art-logics-hw/cell-simulator/README.md

# Cell Simulator

Battery cell simulator hardware design

## Issues

* [ ] `CAN1_TX` and `CAN1_RX` is swapped.
* [ ] R32 (120ohm) between `CAN1_TX` and `CAN1_RX` should be removed.
* [ ] Add 100ohm, 0.5W resistor between GND and V- of U19 DC-DC module for positive/negative balancing.
