art-logics-hw/cell-simulator/hardware/cell-simulator.kicad_pcb

## KiCad design hardware/cell-simulator.kicad_pcb (2022-07-04)

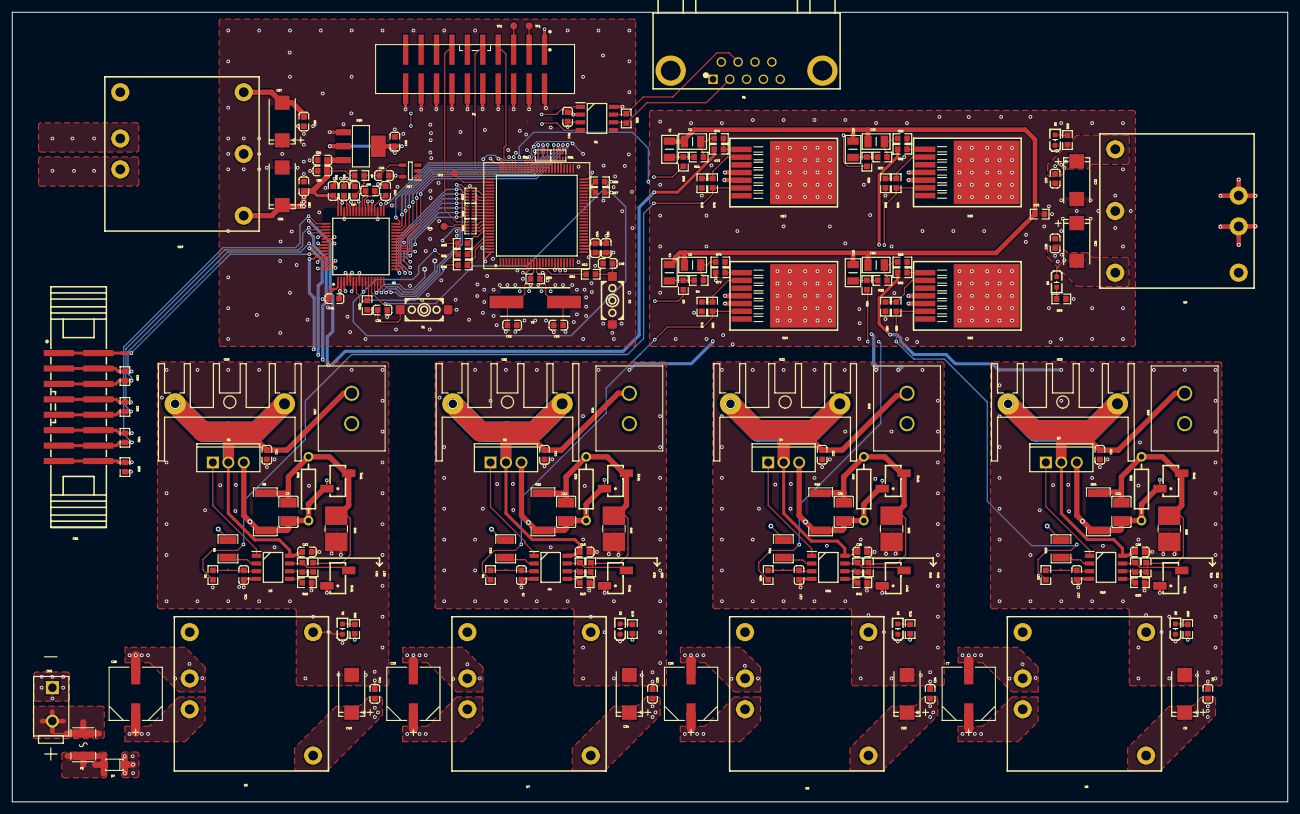
[picture p1: board cell-simulator.kicad_pcb from above]

Board: 4 copper layers, 210.0 x 130.0 mm, 201 parts (0 on the bottom side), 156 nets.

Parts:
C1, C2, C4, C5, C15, C16, C25, C26: CAPC3216X190N
C3, C12, C22, C31: C1210
C6, C9, C10, C11, C13, C14, C17, C18, C19, C21, C24, C27, C28, C30, C35, C37, C38, C39, C40, C41, C42, C44, C45, C46, C47, C48, C49, C50, C51, C52, C53, C54, C55, C58, C59, C60, C61: LC-0603_C
C7, C20, C29, C33: CAP_J-V_8X10P5_RUB
C8, C23, C32, C34, C36, C43, C56, C57: CAPPM7343X310N
CN1: IDC-SMD_16P-P2.54_Z-S230321016M2BLT1
CN2: 39-28-8020
D1, D2, D3, D4, D5, D6: LED0603-R-RD
D7: SOD-123FL_L2.7-W1.8-LS3.8-RD
F1: F1812
P1: CONN-SMD_20P-P2.54_B-3000N20P-0110
Q1, Q2, Q3, Q4: TO255P460X1020X2008-3P
R2, R3, R4, R8, R10, R11, R13, R14, R17, R18, R19, R20, R24, R25, R27, R30, R31, R32, R36, R37, R39, R42, R43, R44, R51, R52, R53, R55, R56, R57, R58, R59, R60, R61, R62, R63, R64, R65, R66, R69, R70, R71, R72, R73, R74, R75, R76, R77, R78, R79, R80, R81, R82, R83, R84, R85, R86, R87, R88, R89, R90: LC-0603_R
R5, R22, R34, R46: R2512
R6, R12, R29, R41: R1210
R16, R23, R35, R47: MF0W4FF6801A50
R21, R33, R45, R67: RX27-5
R48, R49, R50, R68: PA2512FKE7W0R001E
RN1, RN2, RN3, RN4, RN5: RES-ARRAY-SMD_0402-8P-L2.0-W1.0-BL
S1, S2: KEY-SMD_L6.2-W3.6-LS8.0
TP1, TP2, TP3, TP4: PAD-1.2
TPV1, TPV2, TPV3, TPV4, TPV5, TPV6, TPV7, TPV8: HDR-SMD_2P-P2.54-V-M-S4.8
U1: SOIC127P600X175-8N
U2: QFP50P1200X1200X160-64N
U3, U4, U10, U11: LM2904BQDRQ1
U5, U6, U7, U8: URBXXXXYMD-10WR3
U9, U19: URAXXXXYMD-10WR3
U12: QFP50P1600X1600X160-100N
U13, U14, U15, U16: KTW7
U17: SOT95P280X145-5N
U18: SOT-223_L6.5-W3.5-P2.30-LS7.0-BR
U20, U21, U22, U23: HEATSINK-TH_L23.5-W16.0-P18.0_XSD2156-06
X1: DSUB-TH_DMR-9S
Y1: ABLS-12.000MHZ-B2

Connections:
2V5REF: C47.2, C48.1, R55.2, U2.42, U17.4
$$$1152: C3.1, R5.1, R16.1, R17.1, R48.2, TPV1.2
$$$1196: C12.1, R20.1, R22.1, R23.1, R49.2, TPV3.2
$$$1298: C22.1, R32.1, R34.1, R35.1, R50.2, TPV6.2
$$$1418: C31.1, R44.1, R46.1, R47.1, R68.2, TPV8.2
$$$1466: C6.1, R8.2, U4.3
$$$1467: R12.1, U4.2
$$$1468: C4.2, R3.2, R4.1
$$$1469: Q2.1, U4.1
$$$1470: C10.1, C11.1, Q2.2, R21.1, U4.8, U21.1, U21.2
$$$1471: R19.1, TPV2.2, U4.7
$$$1472: R13.2, U4.5
$$$1473: R19.2, R20.2, U4.6
$$$1474: C17.1, R27.2, U10.3
$$$1475: R29.1, U10.2
$$$1476: C15.2, R24.2, R25.1
$$$1477: Q3.1, U10.1
$$$1478: C18.1, C19.1, Q3.2, R33.1, U10.8, U23.1, U23.2
$$$1479: R31.1, TPV4.2, U10.7
$$$1480: R30.2, U10.5
$$$1481: R31.2, R32.2, U10.6
$$$1482: C27.1, R39.2, U11.3
$$$1483: R41.1, U11.2
$$$1484: C25.2, R36.2, R37.1
$$$1485: Q4.1, U11.1
$$$1486: C28.1, C30.1, Q4.2, R45.1, U11.8, U22.1, U22.2
$$$1487: R43.1, TPV7.2, U11.7
$$$1488: R42.2, U11.5
$$$1489: R43.2, R44.2, U11.6
$$$3411: R6.1, U3.2
$$$3420: C21.1, R2.2, U3.3
$$$4490: C1.2, R10.2, R11.1
$$$7976: P1.3, TP1.1
$$$7978: P1.5, TP2.1
$$$8071: TP3.1, U12.77
$$$8097: RN4.7, TP4.1
$$$10062: Q1.1, U3.1
$$$10192: C13.1, C14.1, Q1.2, R67.1, U3.8, U20.1, U20.2
$$$10374: R14.1, TPV5.2, U3.7
$$$10421: R18.2, U3.5
$$$10474: R14.2, R17.2, U3.6
$$$12937: D7.2, F1.2
$$$15374: R73.2, R74.2, U13.1
$$$15480: R75.2, R76.1, U13.2
$$$15551: R77.2, R78.2, U14.1
$$$15552: R79.2, R80.1, U14.2
$$$15559: R81.2, R82.2, U15.1
$$$15560: R83.2, R84.1, U15.2
$$$15562: R85.2, R86.2, U16.1
$$$15563: R87.2, R88.1, U16.2
$$$16325: CN2.2, F1.1
$$$16602: D5.1, R89.1
$$$16631: D6.1, R90.1
$$$18206: C39.1, R51.2, S1.1
$$$18291: C40.1, R52.2, S2.1
$$$18913: R53.1, U1.6, X1.2
$$$18918: R53.2, U1.7, X1.7
$$$20459: C46.1, U2.36
$$$24853: D1.1, R66.2
$$$24877: D3.1, R69.2
$$$24913: D4.1, R71.2
$$$24942: D2.1, R70.2
$$$28916: C52.2, R56.2, U12.12, Y1.2
$$$28919: C53.2, R56.1, U12.13, Y1.1
$$$29529: R57.2, U12.47
$$$29530: R58.2, U12.48
$$$29769: RN1.4, U12.58
$$$29771: RN1.3, U12.57
$$$29772: RN1.2, U12.56
$$$29773: RN1.1, U12.55
$$$29939: RN2.4, U12.62
$$$30112: RN2.1, U12.59
$$$30117: RN2.2, U12.60
$$$30238: RN2.3, U12.61
$$$30640: RN5.1, U12.85
$$$30641: RN5.2, U12.86
$$$30643: RN5.3, U12.87
$$$30645: RN5.4, U12.88
$$$30652: RN3.4, U12.84
$$$30655: RN3.3, U12.83
$$$30661: RN3.2, U12.82
$$$30664: RN3.1, U12.81
$$$30684: RN4.1, U12.89
$$$30687: RN4.2, U12.90
$$$30690: RN4.3, U12.91
$$$30693: RN4.4, U12.92
$$$31167: R60.1, U12.93
$$$31288: R61.1, U12.95
$$$31389: R59.1, U12.96
$$$31870: C57.1, C59.2, U19.5
$$$32347: C45.1, U2.40
$$$32491: C45.2, U2.39
$$$32715: C60.1, U2.44, U2.45
+3V3: C49.1, C54.2, C55.2, P1.1, U2.23, U12.11, U12.19, U12.22, U12.28, U12.50, U12.75, U12.100, U18.2, U18.4
+5V: C41.2, C42.1, C50.1, C51.1, C56.2, C58.1, C61.1, R55.1, U1.3, U2.1, U2.37, U2.38, U2.48, U18.3, U19.3
+9V_1: C43.2, C44.2, R66.1, R67.2, U5.3
+9V_2: C34.2, C35.2, R21.2, R70.1, U7.3
+9V_3: C23.2, C24.2, R45.2, R71.1, U8.3
+9V_4: C8.2, C9.2, R33.2, R69.1, U6.3
+24V: C7.1, C20.1, C29.1, C33.1, D7.1, U5.2, U6.2, U7.2, U8.2, U9.2, U19.2
-24V: C7.2, C20.2, C29.2, C33.2, CN2.1, U5.1, U6.1, U7.1, U8.1, U9.1, U19.1
AD1RST: R51.1, U2.11
BUSY: U2.14, U12.71
C1: C3.2, CN1.13, CN1.14, Q1.3, R5.2, R6.2, R16.2, R64.2, TPV1.1, U2.49
C1A: C2.2, R11.2, R74.1
C1D: R10.1, U12.63
C1I: R2.1, R76.2, U13.6
C2: C12.2, CN1.9, CN1.10, Q2.3, R22.2, R23.2, R63.2, TPV3.1, U2.51
C2A: C5.2, R4.2, R78.1
C2D: R3.1, U12.64
C2I: R8.1, R80.2, U14.6
C3: C31.2, CN1.5, CN1.6, Q4.3, R41.2, R46.2, R47.2, R62.2, TPV8.1, U2.57
C3A: C26.2, R37.2, R82.1
C3D: R36.1, U12.65
C3I: R39.1, R84.2, U15.6
C4: C22.2, CN1.1, CN1.2, Q3.3, R29.2, R34.2, R35.2, TPV6.1, U2.59
C4A: C16.2, R25.2, R86.1
C4D: R24.1, U12.66
C4I: R27.1, R88.2, U16.6
CAN1_RX: RN4.6, U1.4
CAN1_TX: RN4.5, U1.1
CHIPSELECT#: U2.13, U12.70
CONVSTART: R57.1, R61.2, U2.9, U2.10
D0: RN3.8, U2.16
D1: RN3.7, U2.17
D2: RN3.6, U2.18
D3: RN3.5, U2.19
D4: RN5.8, U2.20
D5: RN5.7, U2.21
D6: RN5.6, U2.22
D7: RN5.5, U2.24
D8: RN1.8, U2.25
D9: RN1.7, U2.27
D10: RN1.6, U2.28
D11: RN1.5, U2.29
D12: RN2.8, U2.30
D13: RN2.7, U2.31
D14: RN2.6, U2.32
D15: RN2.5, U2.33
EPAD: U13.8, U14.8, U15.8, U16.8
FIRSTDATA: R60.2, U2.15
GND: C39.2, C40.2, C41.1, C42.2, C46.2, C47.1, C48.2, C49.2, C50.2, C51.2, C52.1, C53.1, C54.1, C55.1, C56.1, C57.2, C58.2, C59.1, C60.2, C61.2, P1.2, P1.4, P1.6, P1.8, P1.10, P1.12, P1.14, P1.16, P1.18, P1.20, S1.2, S2.2, U1.2, U1.8, U2.2, U2.3, U2.4, U2.5, U2.6, U2.8, U2.26, U2.34, U2.35, U2.41, U2.43, U2.46, U2.47, U2.53, U2.54, U2.55, U2.56, U2.61, U2.62, U2.63, U2.64, U12.10, U12.20, U12.27, U12.74, U12.99, U17.5, U18.1, U19.4
GND1: C13.2, C14.2, C21.2, C43.1, C44.1, CN1.15, CN1.16, D1.2, R18.1, R48.1, R65.1, R73.1, TPV5.1, U2.50, U3.4, U5.5
GND2: C6.2, C10.2, C11.2, C34.1, C35.1, CN1.11, CN1.12, D2.2, R13.1, R49.1, R64.1, R77.1, TPV2.1, U2.52, U4.4, U7.5
GND3: C23.1, C24.1, C27.2, C28.2, C30.2, CN1.7, CN1.8, D4.2, R42.1, R63.1, R68.1, R81.1, TPV7.1, U2.58, U8.5, U11.4
GND4: C8.1, C9.1, C17.2, C18.2, C19.2, CN1.3, CN1.4, D3.2, R30.1, R50.1, R62.1, R85.1, TPV4.1, U2.60, U6.5, U10.4
ISO24V+: C32.2, C37.1, R89.2, U9.3, U13.5, U14.5, U15.5, U16.5
ISO24V-: C36.1, C38.2, D6.2, U9.5, U13.4, U14.4, U15.4, U16.4
ISOGND: C32.1, C36.2, C37.2, C38.1, D5.2, R65.2, R72.1, R75.1, R79.1, R83.1, R87.1, R90.2, U9.4
MCURST: R52.1, U12.14
PA13: P1.7, U12.72
PA14: P1.9, U12.76
PB3: P1.13, RN4.8
READDATA#: R58.1, U2.12
SGND: C1.1, C2.1, C4.1, C5.1, C15.1, C16.1, C25.1, C26.1, R72.2
STANDBY#: R59.2, U2.7
