art-logics-hw/cell-simulator/doc/testing.md

# Testing Cell Simulator Hardware and Firmware

## Power Supplies

>> Power Suply Voltage 24.00V.
> JLink and CAN Adapter connected.
> Firmware v1.0.2 flashed.

* **3.25V** for 3.3V of main digital circuit
* **+4.35V / -5.65V** for main DC-DC converter U19

After adding 110 ohm, 0.3W Resistor between GND and V- of DC-DC module U19,
The output voltage became **+4.93V / -5.06V**.
