art-logics-hw/cell-simulator/(commit log)

2022-05-30 add kicad design files imported from EasyEDA.
    [cell-simulator.kicad_sch]
2022-06-15 add schematic and pcb exported from PADs.
    [AL_CSA_Platform0425.kicad_pcb, AL_CSA_Platform0425.kicad_sch]
2022-07-04 Refactoring and CAN Fix: * refactoring overlapped net lebels around MCU and ADC * remove MCU-side 120ohm resister on CAN Tranceiver * fix: swap CAN RX/TX * fix: PA11/12 <----> PB5/6
    [cell-simulator.kicad_sch]
2022-07-04 update OP amp circuit, update PCB.
    [cell-simulator.kicad_pcb, cell-simulator.kicad_sch]
2022-07-05 add FIU relay schematics.
    [cell-simulator.kicad_sch]
2022-07-06 update PCB.
    [cell-simulator.kicad_sch]
2022-07-06 add 100ohm load resistor on -5V of DC-DC module.
    [cell-simulator.kicad_sch]
2022-07-07 add mounting holes.
2022-07-07 update Sch and PCB: fix MCURST, remove A1RST, fix ADC inputs, improve mounting holes.
    [cell-simulator.kicad_sch]
